limonene213u/RISC-V_Akatsuki-I-Tiny/firmware/tiny-monitor/User/spi.c

#include "spi.h"
#include "board.h"

void spi_init(void)
{
    GPIO_InitTypeDef gpio = {0};
    SPI_InitTypeDef spi = {0};
    RCC_APB2PeriphClockCmd(RCC_APB2Periph_GPIOA | RCC_APB2Periph_SPI1, ENABLE);
    gpio.GPIO_Pin = SRAM_CS_PIN;
    gpio.GPIO_Mode = GPIO_Mode_Out_PP;
    gpio.GPIO_Speed = GPIO_Speed_50MHz;
    GPIO_Init(SRAM_PORT, &gpio);
    GPIO_SetBits(SRAM_PORT, SRAM_CS_PIN);
    gpio.GPIO_Pin = SRAM_SCK_PIN | SRAM_MOSI_PIN;
    gpio.GPIO_Mode = GPIO_Mode_AF_PP;
    GPIO_Init(SRAM_PORT, &gpio);
    gpio.GPIO_Pin = SRAM_MISO_PIN;
    gpio.GPIO_Mode = GPIO_Mode_IN_FLOATING;
    GPIO_Init(SRAM_PORT, &gpio);

    spi.SPI_Direction = SPI_Direction_2Lines_FullDuplex;
    spi.SPI_Mode = SPI_Mode_Master;
    spi.SPI_DataSize = SPI_DataSize_8b;
    spi.SPI_CPOL = SPI_CPOL_Low;
    spi.SPI_CPHA = SPI_CPHA_1Edge;
    spi.SPI_NSS = SPI_NSS_Soft;
    spi.SPI_BaudRatePrescaler = SPI_BaudRatePrescaler_8;
    spi.SPI_FirstBit = SPI_FirstBit_MSB;
    spi.SPI_CRCPolynomial = 7;
    SPI_Init(SPI1, &spi);
    SPI_Cmd(SPI1, ENABLE);
}

void spi_select(void) { GPIO_ResetBits(SRAM_PORT, SRAM_CS_PIN); }
void spi_deselect(void) { GPIO_SetBits(SRAM_PORT, SRAM_CS_PIN); }
uint8_t spi_transfer(uint8_t value)
{
    while (SPI_I2S_GetFlagStatus(SPI1, SPI_I2S_FLAG_TXE) == RESET) {}
    SPI_I2S_SendData(SPI1, value);
    while (SPI_I2S_GetFlagStatus(SPI1, SPI_I2S_FLAG_RXNE) == RESET) {}
    return (uint8_t)SPI_I2S_ReceiveData(SPI1);
}
