limonene213u/RISC-V_Akatsuki-I-Tiny/(commit log)

2026-09-30 Add Rev0.3 parts list
    [parts_list_rev03.csv]
2026-09-30 Add Rev0.3 netlist
    [netlist_rev03.csv]
2026-09-30 Add Rev0.3 assembly BOM
2026-09-30 Add Rev0.3 JLCPCB Gerber archive
2026-09-30 Add Rev0.3 KiCad project settings
2026-09-30 Add Rev0.3 footprint library table
2026-09-30 Add Rev0.3 KiCad source archive
2026-09-30 Remove incomplete binary archive hardware/rev03/manufacturing/gerber_rev03_JLC.zip
